wait-how/Nomad/hardware/README.md

# Hardware docs

 - `schematic_v1.0.pdf`: The schematic for the constructed board.
 - `schematic_v1.1.pdf`: The schematic for the never built 1.1 bugfix revision
 - `pcb_v1.0.pdf`: The PCB for the constructed board.
 - `eeprom write 6.txt`, `eeprom write 6.png`: Falstad circuit and output of the address decode logic.
 - `periph 5.txt`, `periph 5.png`: Falstad circuit and output for the peripheral decode logic.
 - `Photos`: Photos of the rev 1 board under construction and fully assembled.
