wait-how/Nomad/hardware/eeprom write 6.png

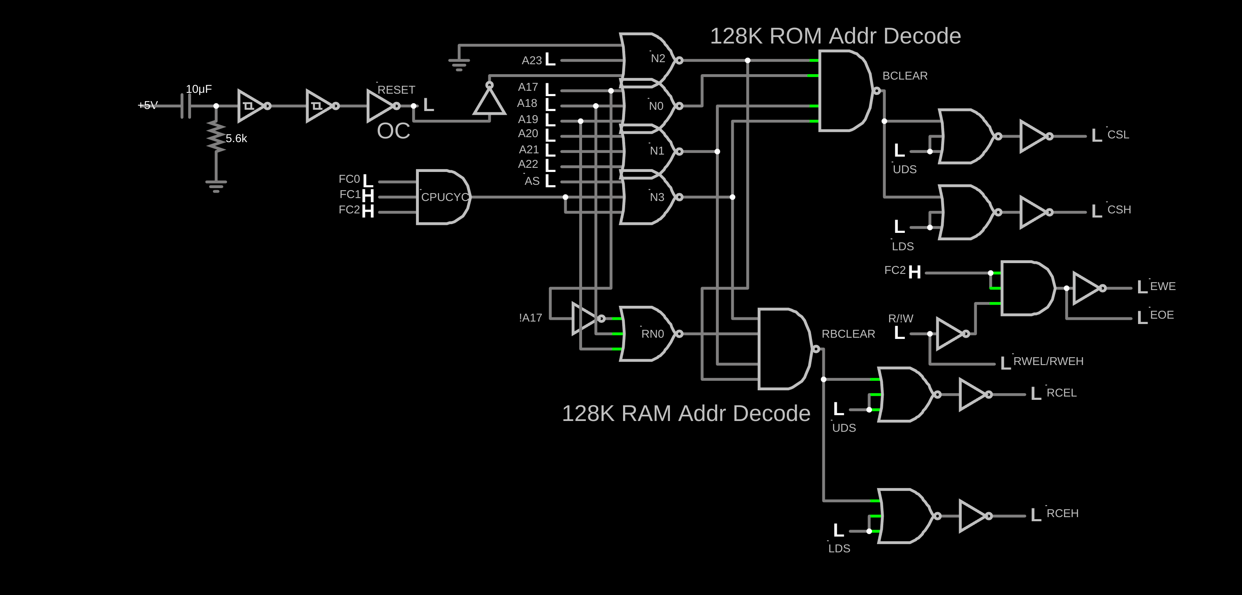
hardware/eeprom write 6.png
