wait-how/Nomad/hardware/periph 5.png

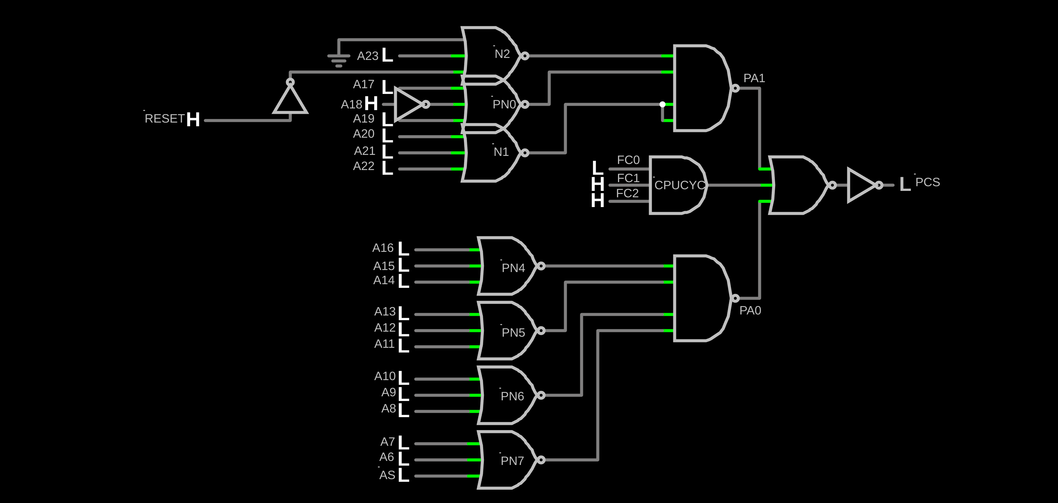
hardware/periph 5.png
