wait-how/Nomad/hardware/Photos/Adapter Built.jpeg

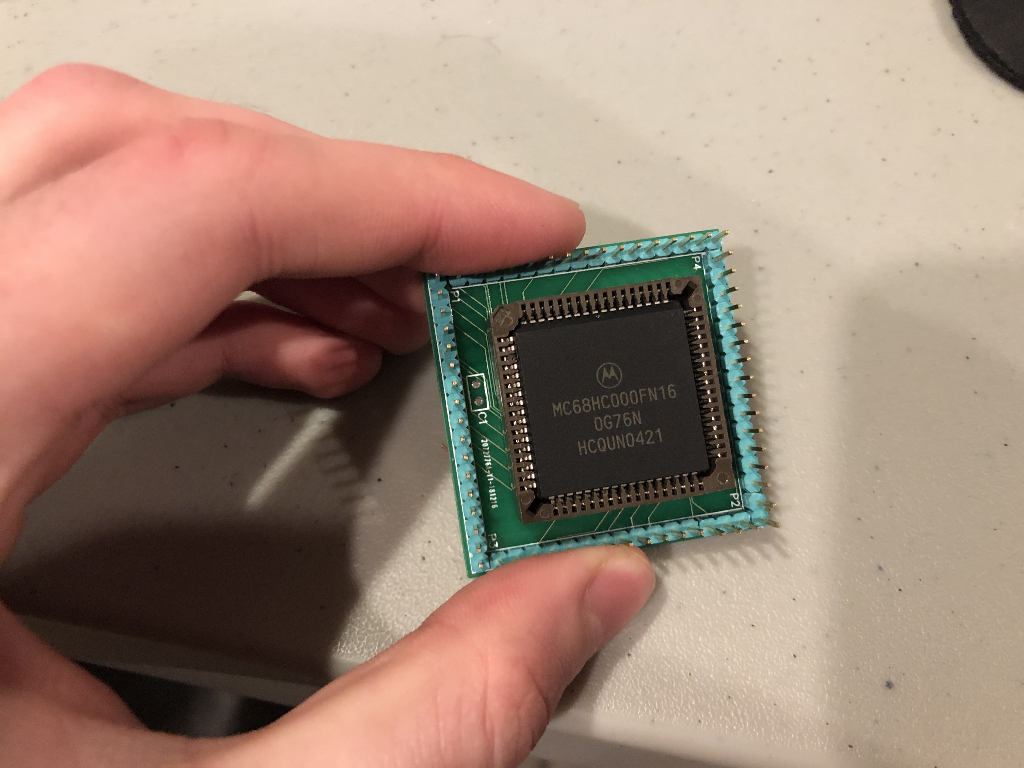
hardware/Photos/Adapter Built.jpeg
