wait-how/Nomad/hardware/Photos/Adapter Final.jpeg

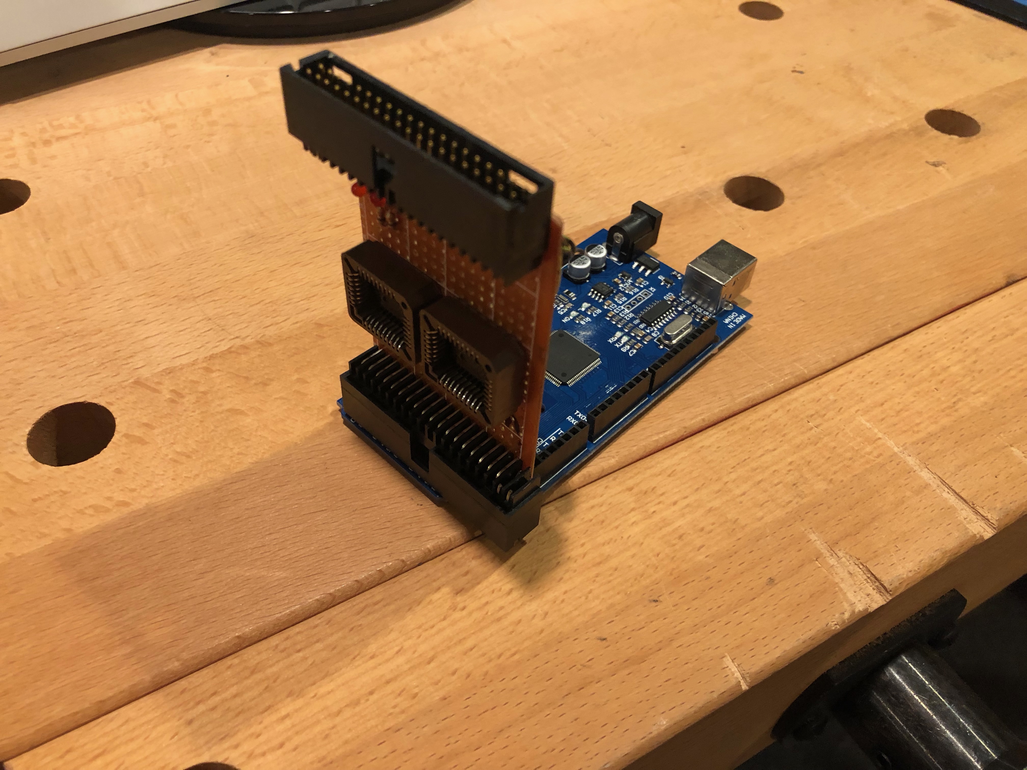
hardware/Photos/Adapter Final.jpeg
