wait-how/Nomad/hardware/Photos/Board 1:2 Built.jpeg

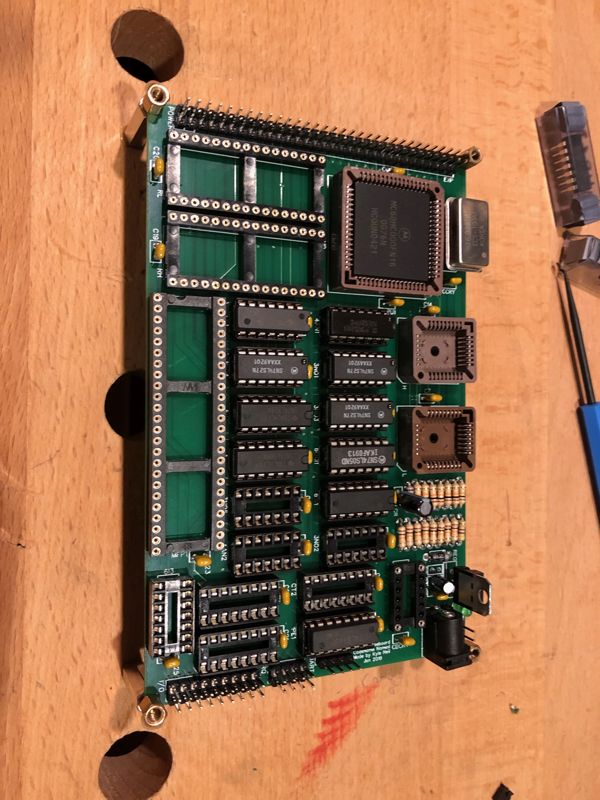
hardware/Photos/Board 1:2 Built.jpeg
