wait-how/Nomad/hardware/Photos/Board Empty.jpeg

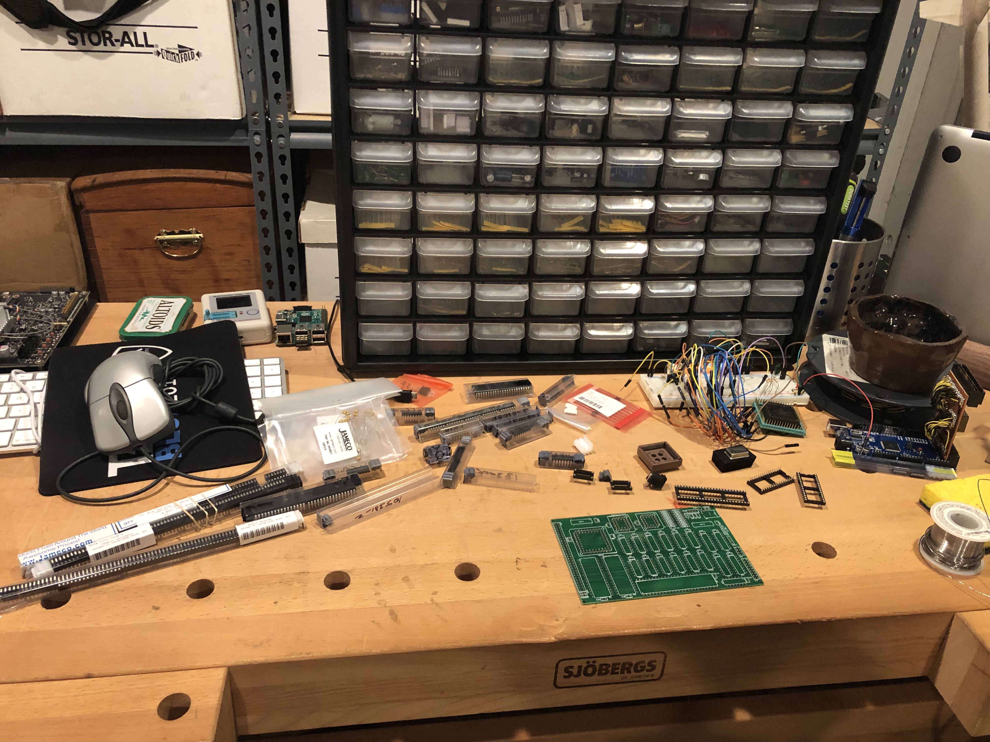
hardware/Photos/Board Empty.jpeg
