wait-how/Nomad/hardware/Photos/Board Finished.jpeg

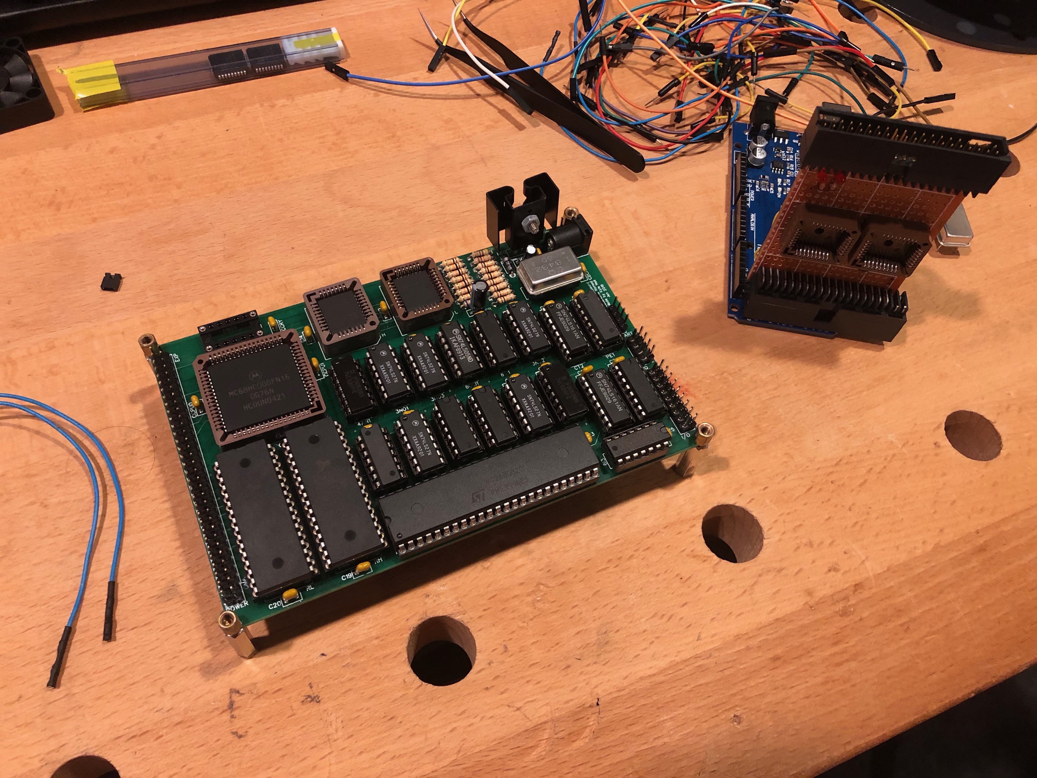
hardware/Photos/Board Finished.jpeg
