wait-how/Nomad/hardware/Photos/Board Populated Passive.jpeg

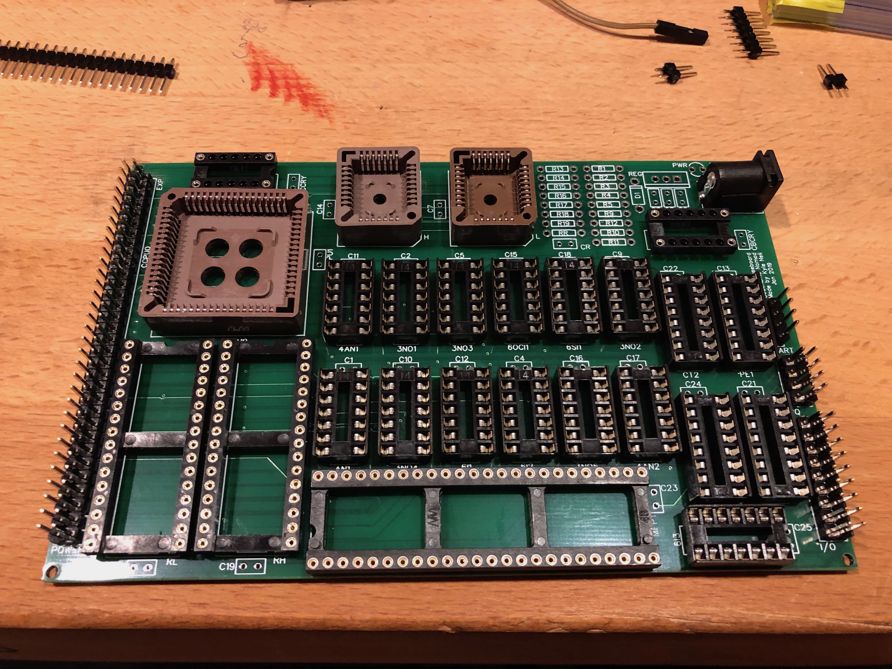
hardware/Photos/Board Populated Passive.jpeg
