wait-how/Nomad/hardware/Photos/EEPROM Programmer Standalone.jpeg

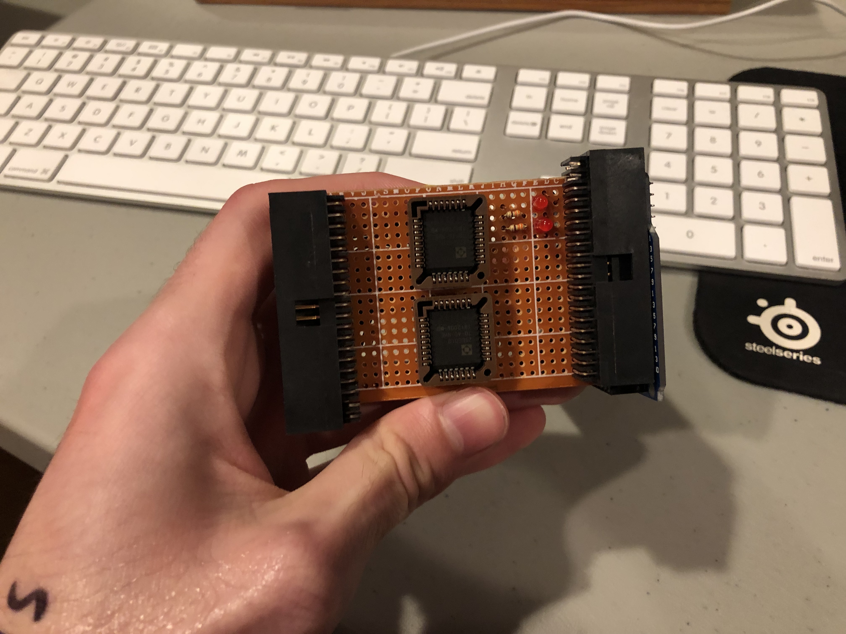
hardware/Photos/EEPROM Programmer Standalone.jpeg
