wait-how/Nomad/hardware/Photos/EEPROM Programmer with Arduino.jpeg

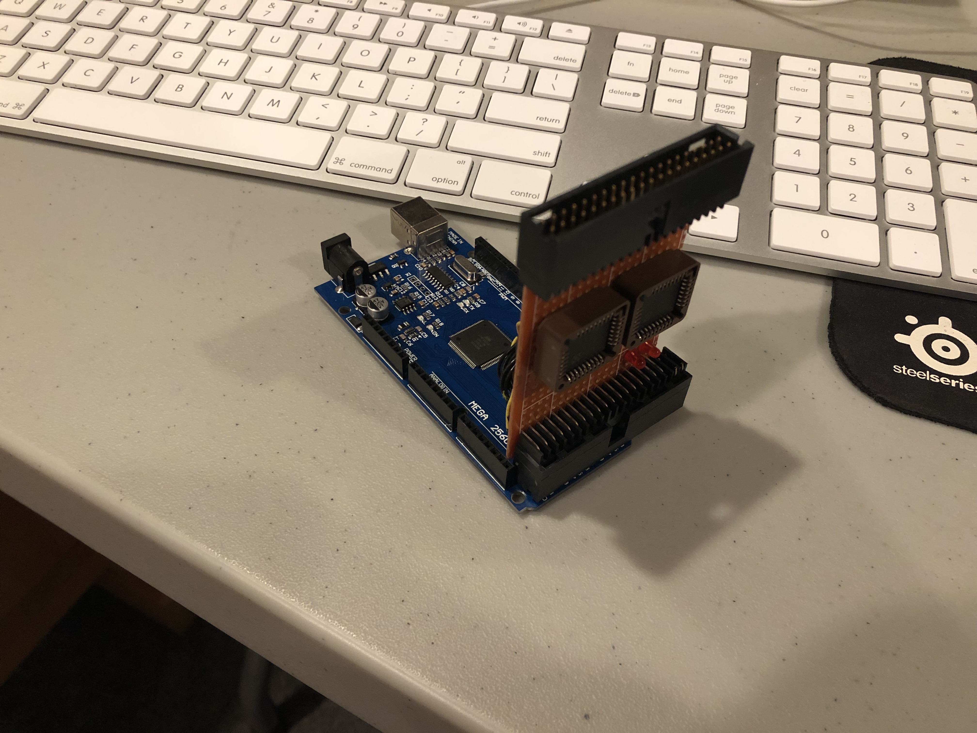
hardware/Photos/EEPROM Programmer with Arduino.jpeg
