wait-how/Nomad/hardware/Photos/Processor Freerun Probe.jpeg

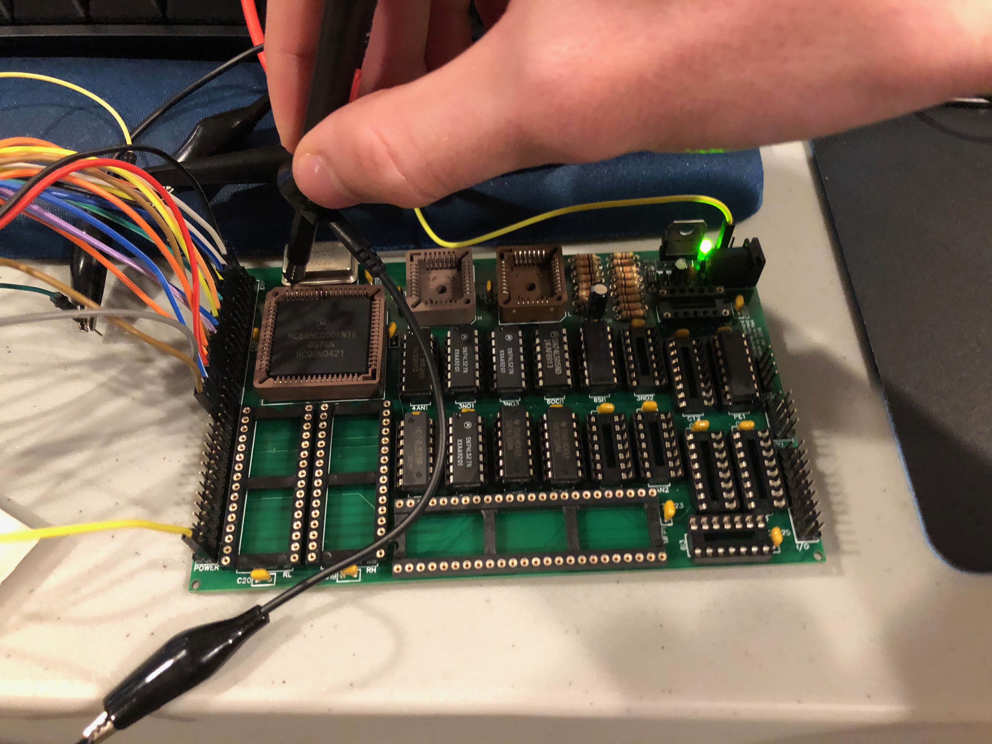
hardware/Photos/Processor Freerun Probe.jpeg
