wait-how/Nomad/docs/components.md

# Components
| Quantity | Part | Description |
| --- | --- | --- |
| 2 | GLS29EE010 | EEPROM chip |
| 2 | AS6C1008 | SRAM chip |
| 1 | 0.33μF ceramic cap |  |
| 1 | DC jack |  |
| 1 | 74LS11 | Triple 3-input AND gate |
| 2 | 10μF capacitor |  |
| 1 | 5.6KΩ resistor |  |
| 1 | 74LS14 | Schmitt-trigger inverter |
| 1 | 74LS05 | Open-collector hex inverter |
| 1 | 3mm Power LED |  |
| 1 | 470Ω Resistor |  |
| 1 | 1N4007RLG | Diode |
| 1 | 1.8432 MHz crystal |  |
| 3 | 1x2 male header |  |
| 1 | MC68HC000FN16 | 68k processor |
| 2 | 74LS20 | Dual 4-input NAND gate |
| 5 | 74LS27 | Triple 3-input NOR gate |
| 2 | 74LS04 | Hex inverter |
| 2 | 74LS161 | 4-bit binary counter |
| 1 | MK68901 | Multi-function peripheral |
| 15 | 10KΩ Resistor |  |
| 1 | 12MHz crystal | Processor clock |
| 1 | 2x4 male header |  |
| 1 | 1x4 male header |  |
| 1 | 74LS138 | 3-to-8 decoder |
| 1 | 74HCT04 | Hex inverter |
| 1 | 74LS148 | 8-to-3 encoder |
| 1 | 2x9 male header |  |
| 1 | L7805ABV | Linear voltage regulator |
