wait-how/Nomad/hardware/Photos/Adapter Testing.jpeg

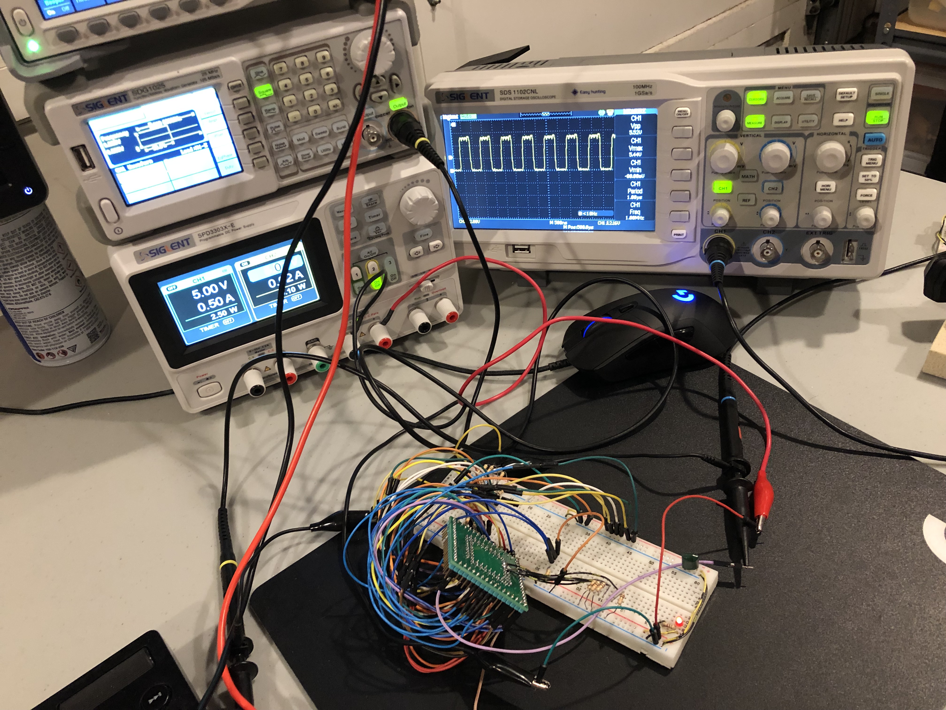
hardware/Photos/Adapter Testing.jpeg
