wait-how/Nomad/hardware/Photos/Power Supply Testing.jpeg

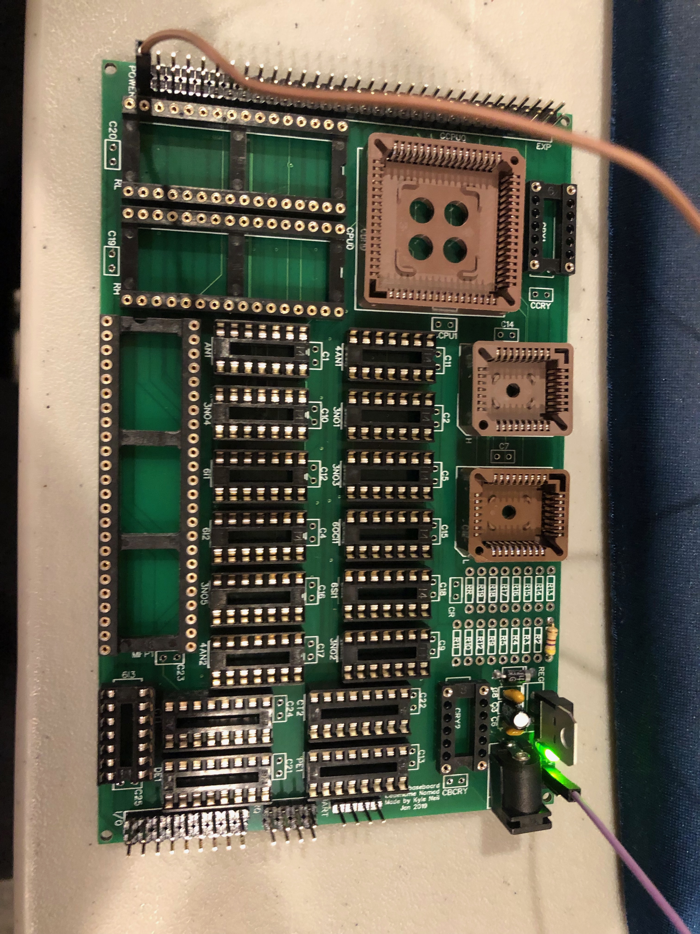
hardware/Photos/Power Supply Testing.jpeg
