wait-how/Nomad/hardware/Photos/Processor Data Bus Testing.jpeg

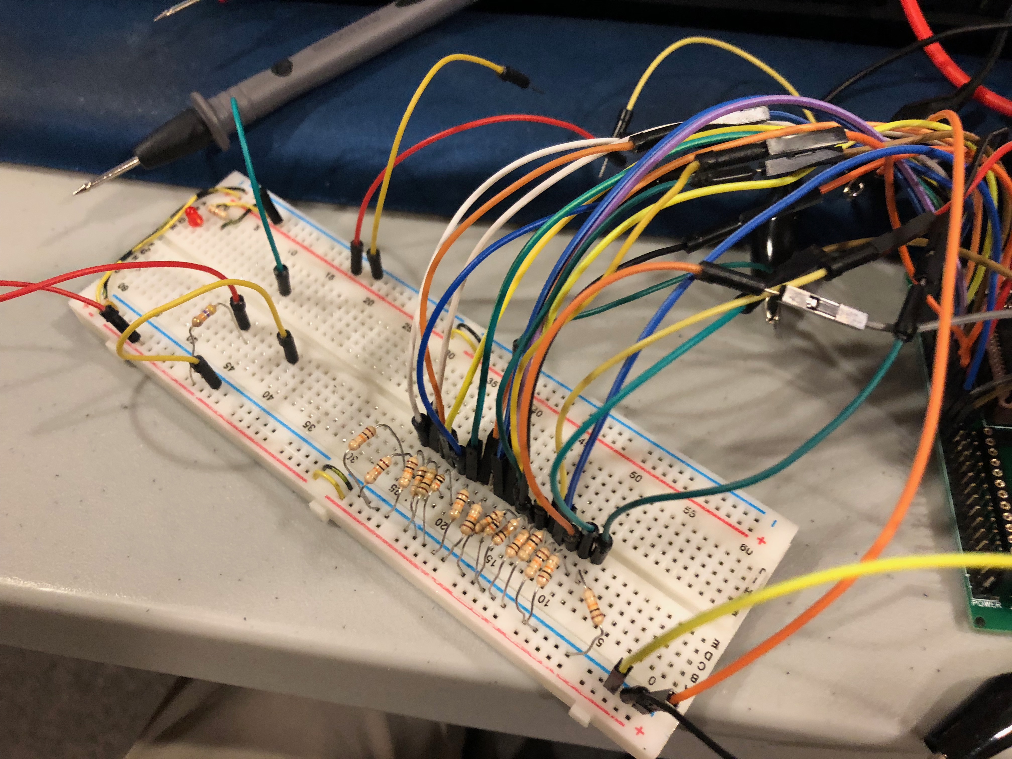
hardware/Photos/Processor Data Bus Testing.jpeg
