wait-how/Nomad/hardware/Photos/Processor Freerun Testing.jpeg

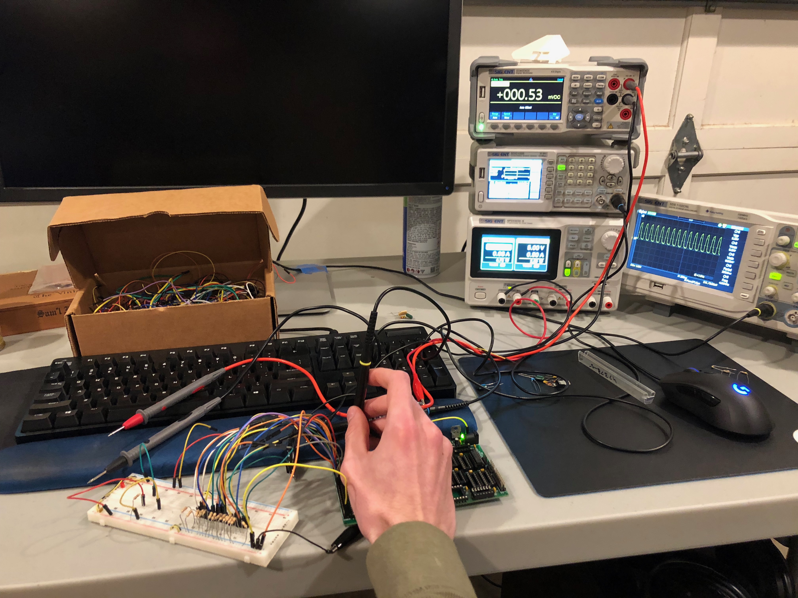
hardware/Photos/Processor Freerun Testing.jpeg
