wait-how/Nomad/hardware/schematic_v1.1.pdf

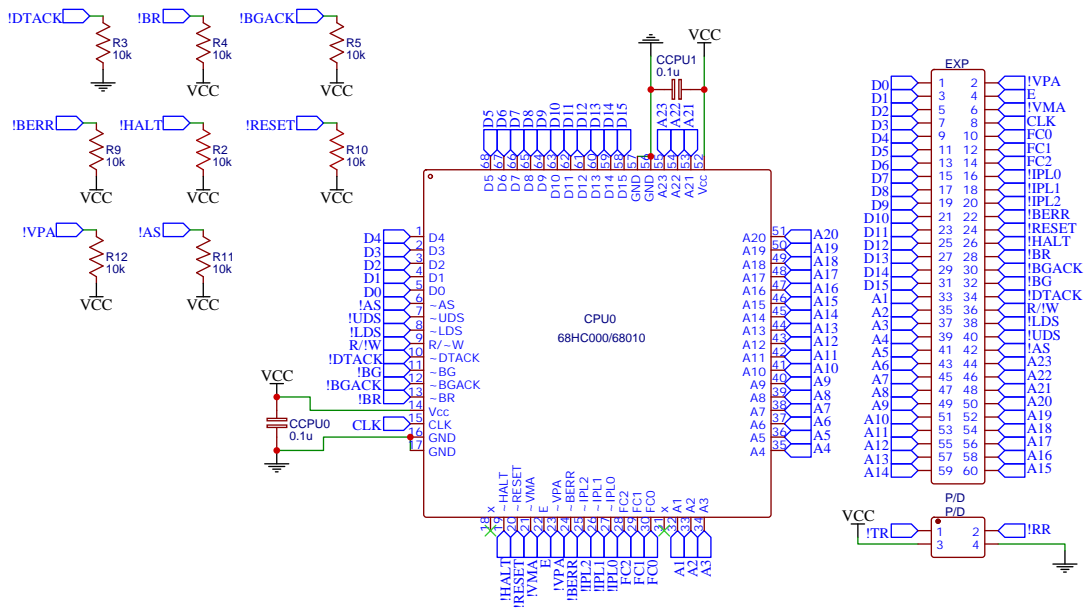
[picture p17: page 1]

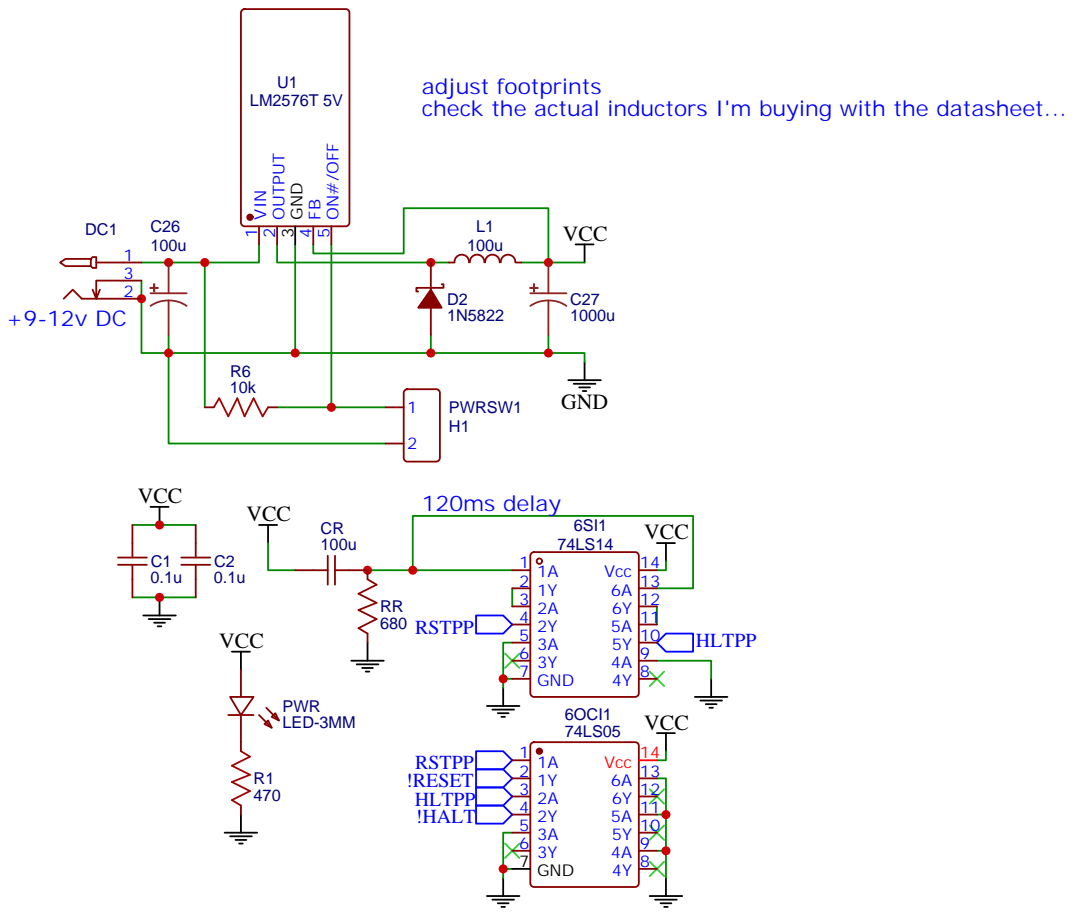
[picture p18: page 2]

adjust footprints
check the actual inductors I'm buying with the datasheet...

# DQ3 17 DQ4 18 DQ5 19 DQ6 20 DQ7 21 ~CE 22 A10 23 ~OE 24

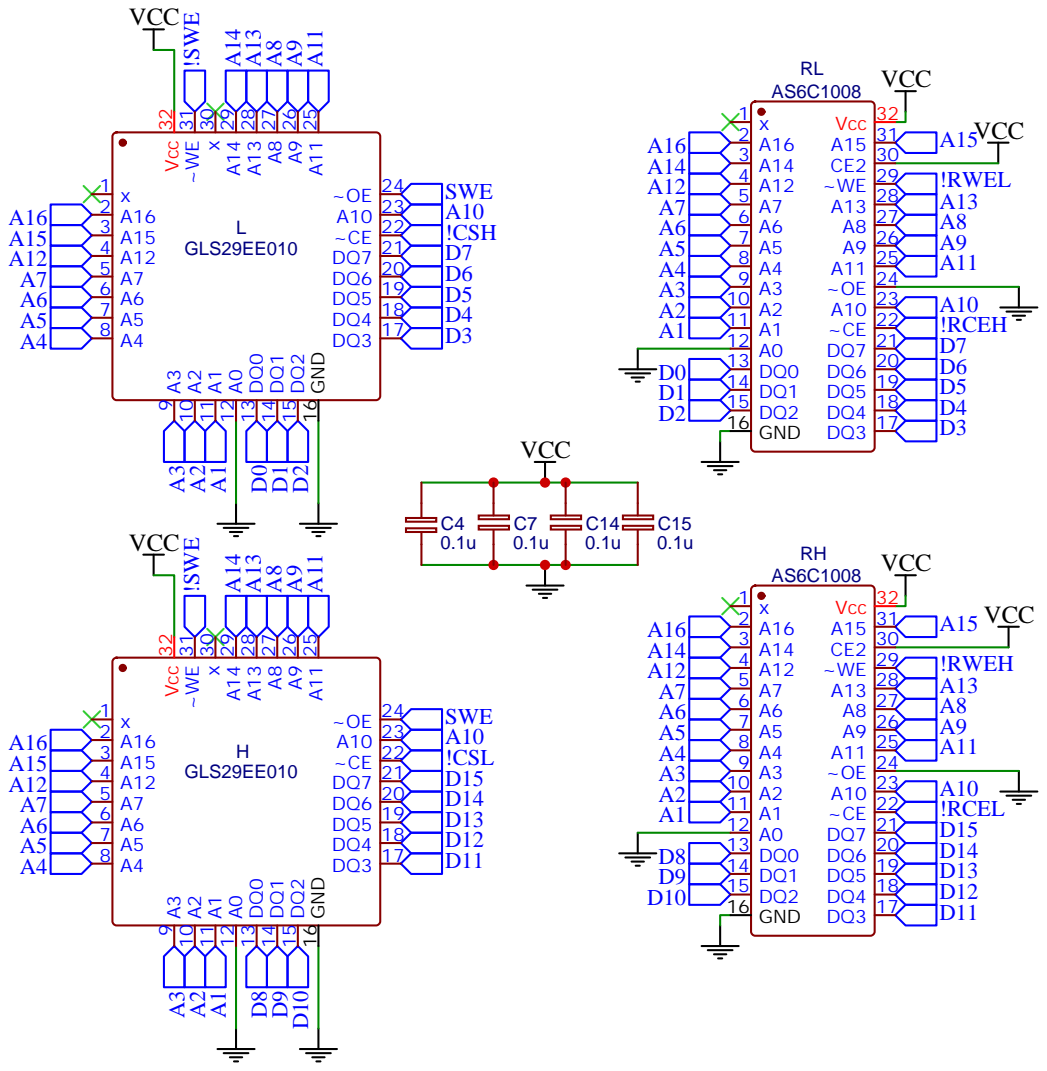
[picture p19: page 3]

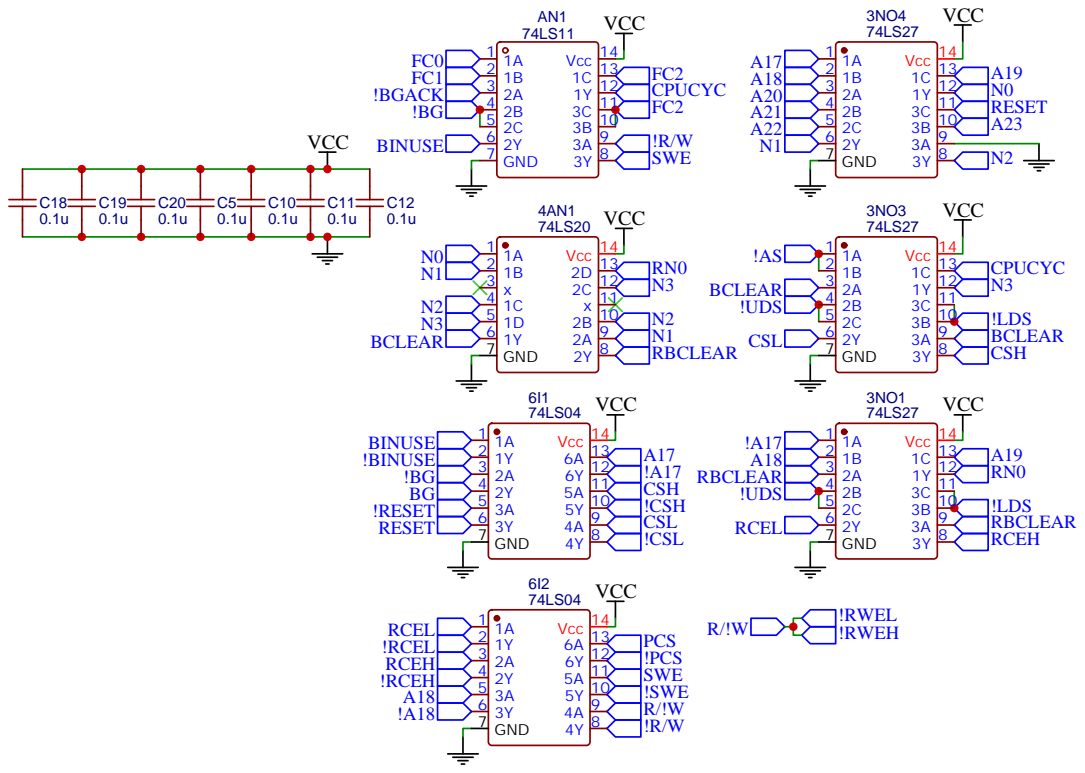
[picture p20: page 4]

VCC

" -" indicates bug or optimization has been handled
Bugs:
- UART RX buffering is swapped
- DMA is broken, peripherals will not be selected once something else becomes bus master
- R/C vals are wrong
- 10uF caps wrong footprint
- mounting holes were too small - right size should be ~126 mil (arduino hole size)
- SDP needs to be turned off - SKIP, hard to fix and SDP isn't required for basic operation
- adjust silkscreen to rev 1.1 - no new features, just bug fixes
- use 0.01uF bypass caps on the crystals instead of 0.1uF
- Output buffer inverts UART signals, need another buffer to turn em back
fix silkscreen issue with expansion connector
- Falstad simulation with the interrupt signal is wrong
- Byte selection signals on EEPROM and RAM are backwards
- UDS and LDS signals on EEPROM and RAM chips can be grounded as they are never accessed
on an odd boundary and the UDS and LDS signals on A0s were always low when device was selected Optimizations:
- Vcc/GND go on the inside, signals go anywhere, because we can't do a 2-layer board
and cutting internal traces is a lot more dangerous
Use fancy sockets for everything?
Buy a 68010 once the 68000 works and use that, monitor power consumption increase
Get power consumption back down by using something better than a 7805. Not hard, and a good idea

TODO: print out the final PCB and check that all the components still fit (use 1:1 ratio for actual size)

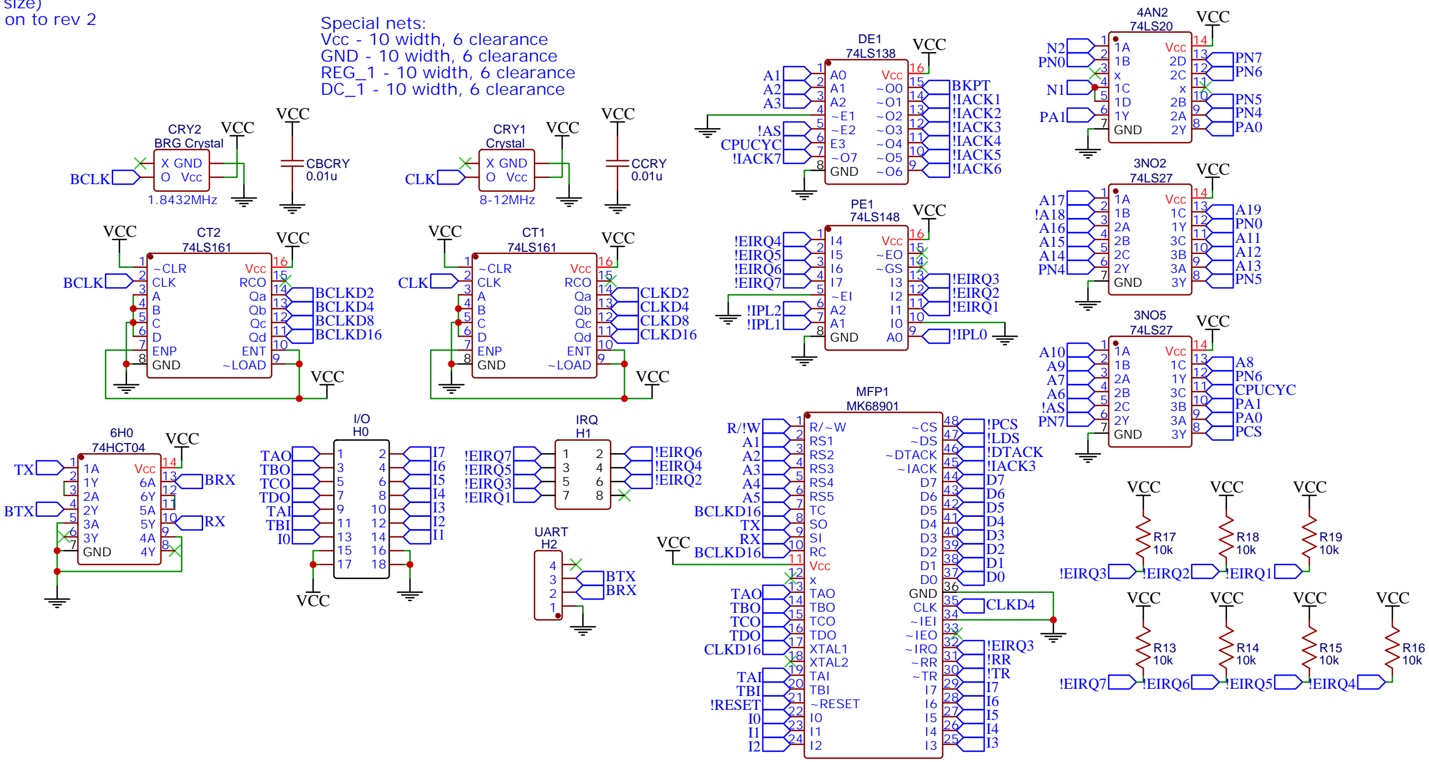
[picture p21: figure]
VCC; CLK; CLKD2; CLKD4 CLKD8 CLKD16; !EIRQ1; !EIRQ2; !EIRQ3; !EIRQ4 !EIRQ5 !EIRQ6 !EIRQ7; !EIRQ2 !EIRQ3; !EIRQ5; !EIRQ4 !EIRQ7; !EIRQ6; !LDS; CLKD4; !DTACK; !RESET; TAO TBO TCO TDO; TAI TBI; TAO TBO TCO TDO TAI TBI; CLKD16; PA1 PA0 PCS; !PCS; !IPL0; !IPL1; !IPL2; !EIRQ7; !EIRQ4; !AS CPUCYC; BKPT !IACK1 !IACK2 !IACK3 !IACK4 !IACK5 !IACK6; !IACK7; !IACK3; BCLK; BCLKD2; BCLKD4 BCLKD8 BCLKD16; BCLKD16; 1.8432MHz; 8-12MHz; BTX BRX; Special nets: Vcc - 10 width, 6 clearance GND - 10 width, 6 clearance REG_1 - 10 width, 6 clearance DC_1 - 10 width, 6 clearance; CPUCYC; BRX; RX BTX; ~CLR 1 CLK 2 A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

Byte select issue is going to be really hard to fix on the rev 1 board, check it carefully and move on to rev 2 since this ~might~ be serious enough to require a respin on its own
test interrupt handling of I/O event to MFP
test interrupt handling of external interrupt source - have to pull the data bus down/up to select
the right interrupt vector
test timers on MFP
test DMA
On the software side:
comment check:
- Arduino - DONE
- Assembly - not finished
- Python - NOT DONE
- Make sure everything is commented and there are no TODOs before releasing code Halt public release until everything is tested and I have a hello world working

# ENT 10 Qd 11 Qc 12 Qb 13 Qa 14 RCO 15 Vcc 16

0.1u

C9
0.1u

C13
0.1u

C16
0.1u

C17
0.1u

C21
0.1u

C22
0.1u

C23
0.1u

C24
0.1u

C25
