wait-how/Nomad/hardware/pcb_v1.0.pdf

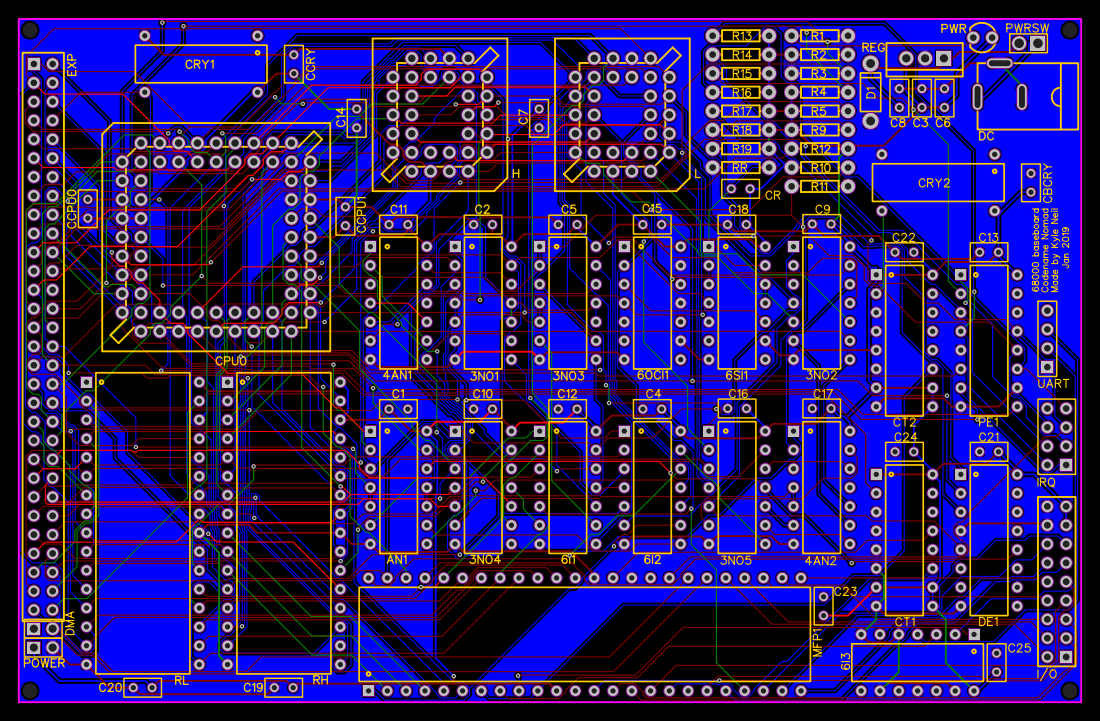
[picture p22: page 1]
