wait-how/Nomad/hardware/schematic_v1.0.pdf

## VCC

## VCC

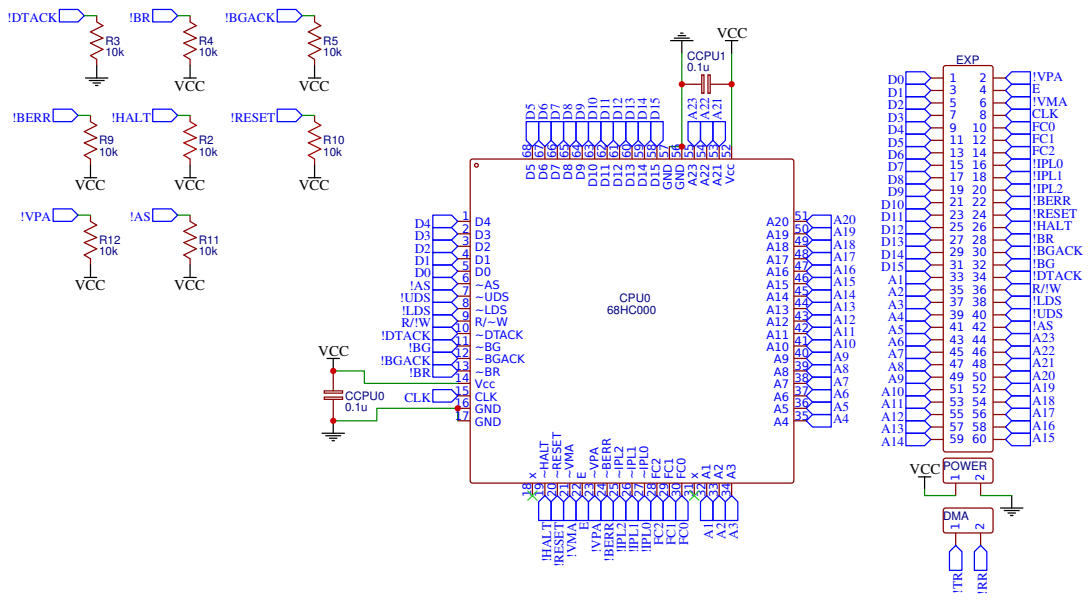
[picture p23: page 1]

## VCC

## +9-12v DC

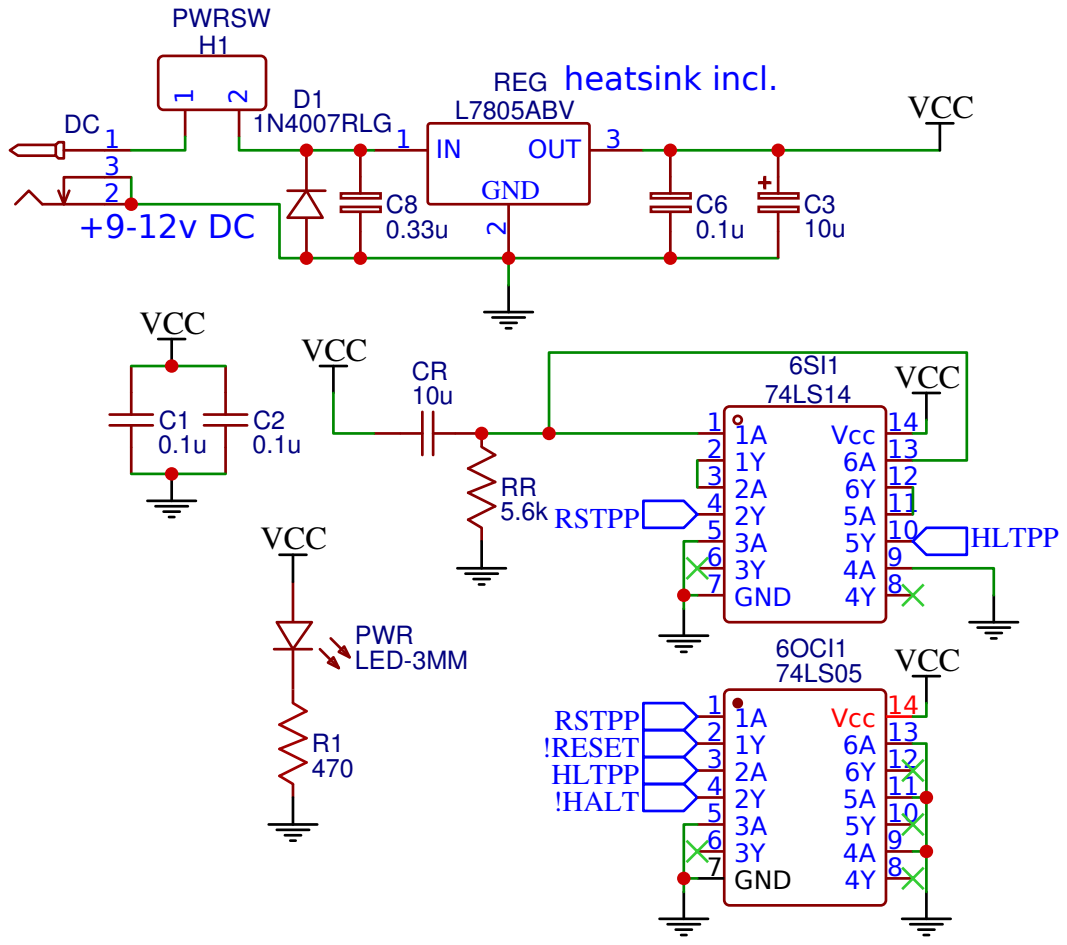
[picture p24: page 2]
L7805ABV; REG; GND; 2 OUT 3; VCC; !RESET; !HALT; GND 7; 4Y 8 4A 9 5Y 10 5A 11 6Y 12 6A 13 Vcc 14; 6OCI1; RSTPP; HLTPP; heatsink incl.; LED-3MM; PWR; 1N4007RLG; PWRSW

# DQ3 17 DQ4 18 DQ5 19 DQ6 20 DQ7 21 ~CE 22 A10 23 ~OE 24

## VCC

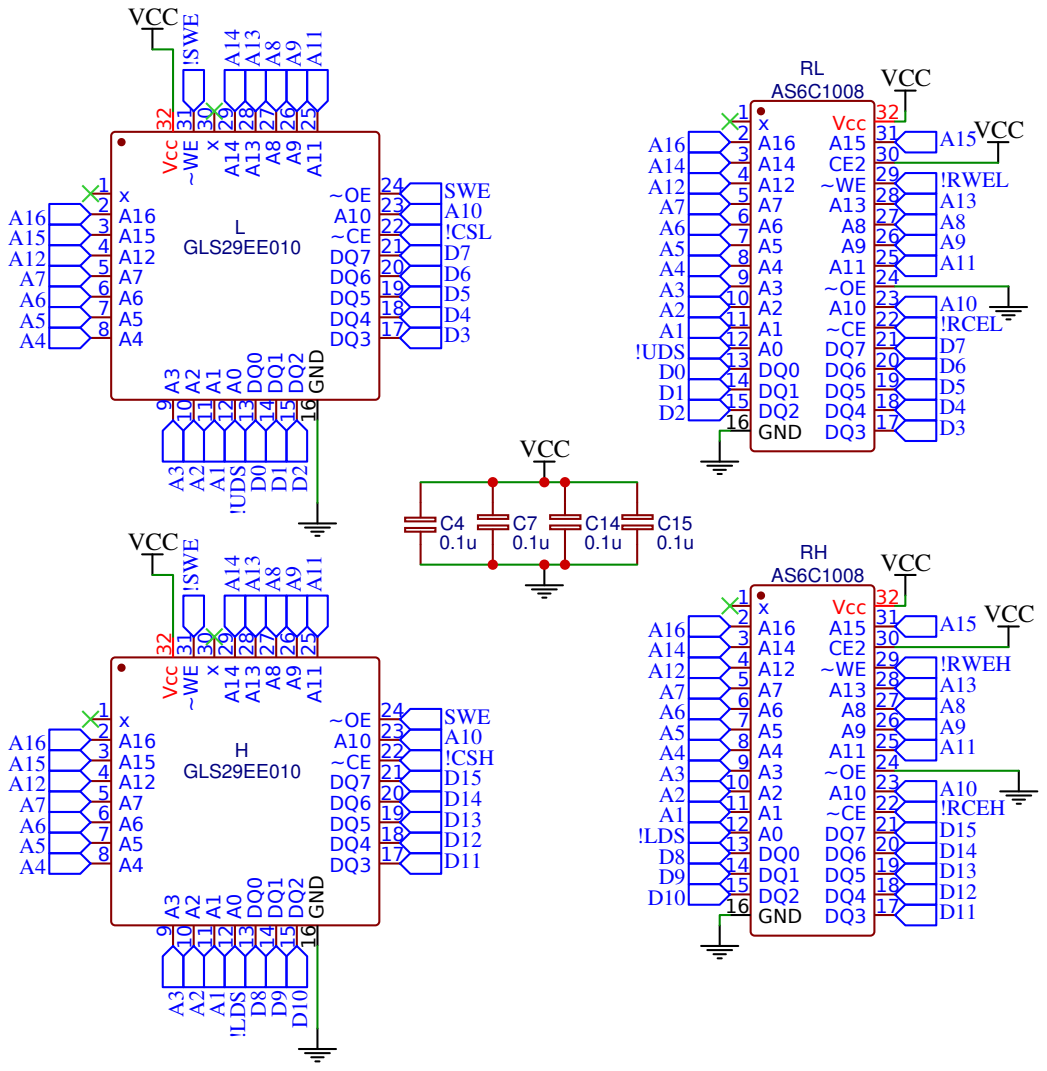
[picture p25: page 3]

# 8 3A 9 3B 10 3C 11 1Y 12 1C 13 Vcc 14

# 8 3A 9 3B 10 3C 11 1Y 12 1C 13 Vcc 14

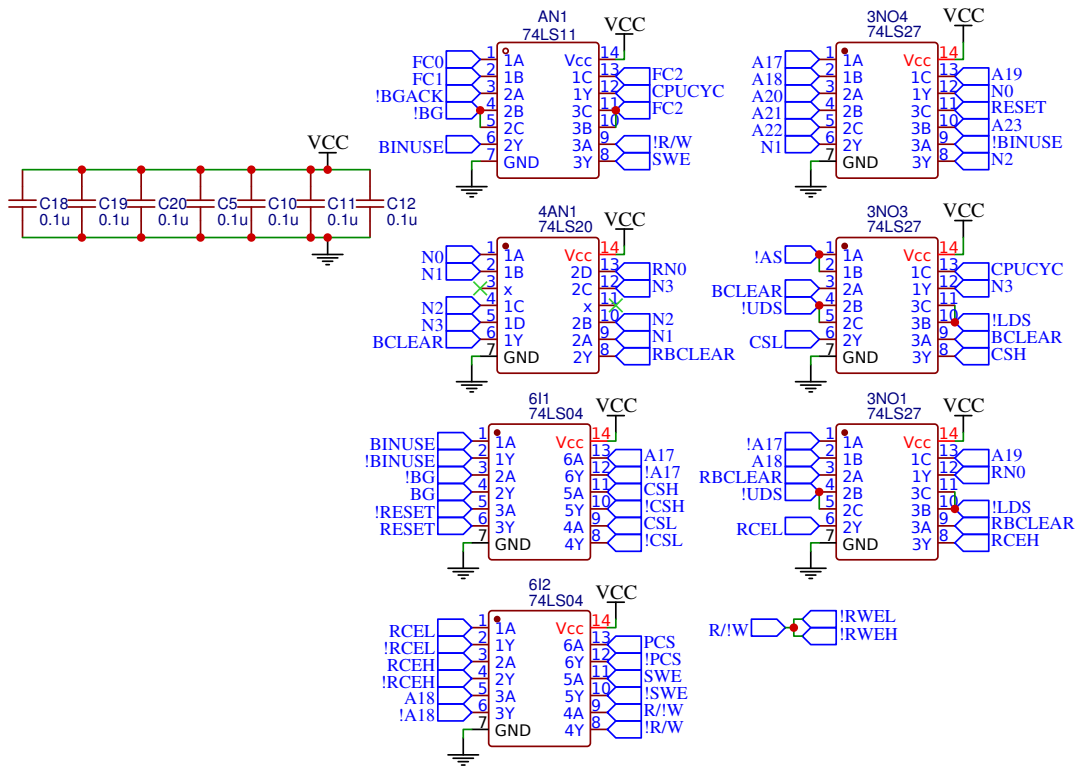
[picture p26: page 4]

## VCC

## VCC

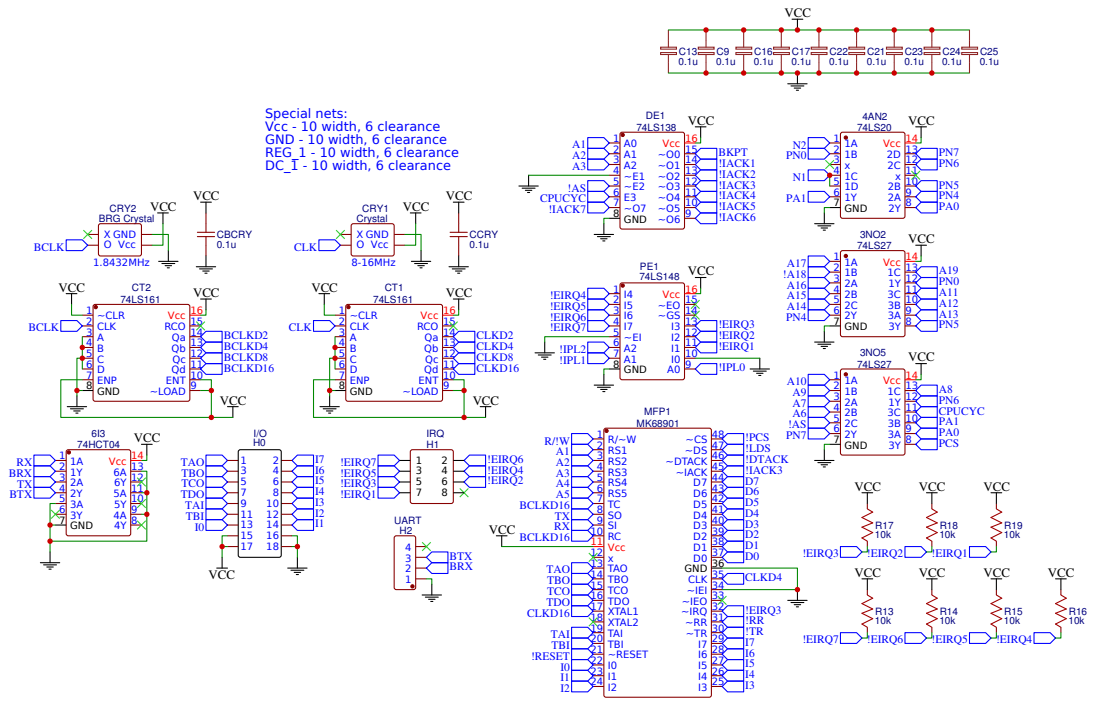
[picture p27: page 5]
