wait-how/Nomad/(commit log)

2022-03-24 adding more documents currently stored elsewhere
2022-03-24 added pics of decode logic and rev1.1 schematic
